LibreSolid/Metamaquina2/(list of files, cad)

Other CAD files:
Metamaquina_2_extruders.scad
