LibreSolid/Metamaquina2/metamaquina2/y_axis/motor/motor_holder.py

"""The lasercut plate that hangs the Y motor off the rear bars."""

from metamaquina2.part import SheetPart
from metamaquina2.scad import machine


class YMotorHolder(SheetPart):
    """One plate, slotted so the motor can be moved to tension the belt."""

    def profile(self):
        return machine.YMotorHolder_face()
