LibreSolid/Metamaquina2/metamaquina2/x_stage/carriage/belt_clamp.py

"""An X belt clamp and the bolts that tighten it."""

from solid_node.node import AssemblyNode
from solid_node.parameters import Flag, Length

from metamaquina2.hardware.bolt import Bolt
from metamaquina2.hardware.m3_washer import M3Washer
from metamaquina2.params import m3_washer_thickness
from metamaquina2.x_stage.carriage.belt_clamp_plate import XBeltClampPlate


class XBeltClamp(AssemblyNode):
    """One clamp: a plate and two M3x20 through it into the carriage.

    `flipped` is the other end of the belt.  The design mirrors the
    clamp there, and a flat plate mirrored in its own plane is the same
    piece turned over -- so it is turned over, and lifted back by its
    own thickness so it still lies where it was.  The bolts are on the
    mirror line, so they are the same either way.
    """

    # where the two bolts stand either side of the clamp's centre
    bolt_offset = 9

    bolt_length = Length(20.0, min=0)

    flipped = Flag(False)

    plate = XBeltClampPlate()
    washers = M3Washer().repeat(2)
    bolts = Bolt(diameter=3, length=bolt_length).repeat(2)

    def render(self):
        if self.flipped:
            (self.plate
             .rotate(180, [1, 0, 0])
             .translate([0, 0, XBeltClampPlate.clamp_thickness]))

        for index, side in enumerate((-1, 1)):
            (self.washers[index]
             .translate([side * self.bolt_offset, 0, 0])
             .rotate(180, [1, 0, 0]))
            (self.bolts[index]
             .translate([0, 0, m3_washer_thickness])
             .translate([side * self.bolt_offset, 0, 0])
             .rotate(180, [1, 0, 0]))
