LibreSolid/Metamaquina2/metamaquina2/y_axis/platform/sandwich_bolt.py

"""The washer and bolt that pull a bearing sandwich together."""

from solid_node.node import AssemblyNode
from solid_node.parameters import Length

from metamaquina2.hardware.bolt import Bolt
from metamaquina2.hardware.m3_washer import M3Washer
from metamaquina2.params import m3_washer_thickness


class SandwichBolt(AssemblyNode):
    """One M3x30 through the platform, its spacers and its sandwich
    plate, with a washer under the head.

    Drawn head-up from the origin; the platform turns it over to drive
    it downwards.
    """

    length = Length(30.0, min=0)

    washer = M3Washer()
    bolt = Bolt(diameter=3, length=length)

    def render(self):
        self.bolt.translate([0, 0, m3_washer_thickness])
