LibreSolid/Metamaquina2/metamaquina2/x_stage/ends/bearing_sandwich.py

"""The bearing sandwich of an X end: a plate and the spacers behind it."""

from solid_node.node import AssemblyNode

from metamaquina2.hardware.double_m3_spacer import DoubleM3Spacer
from metamaquina2.params import bearing_sandwich_spacing, thickness
from metamaquina2.x_stage.ends.sandwich_plate import XEndSandwichPlate


#: Where the four pairs of stacked spacers stand in the plate's plane.
SPACER_HOLES = ((-14, 0), (-14, 45), (14, 0), (14, 45))


class XEndBearingSandwich(AssemblyNode):
    """What holds the two Z bearings against the back plate.

    Four pairs of stacked spacers set the gap and one plate closes it,
    so the bearings are clamped rather than glued in.  It stands on
    edge: the plate faces along the beam.
    """

    spacer_holes = SPACER_HOLES

    spacers = DoubleM3Spacer().repeat(len(SPACER_HOLES))
    plate = XEndSandwichPlate()

    def render(self):
        def standing(node, offset):
            return (node
                    .rotate(90, [0, 0, 1])
                    .rotate(90, [0, 1, 0])
                    .translate([offset, 0, 0]))

        for spacer, (x, y) in zip(self.spacers, self.spacer_holes):
            standing(spacer.translate([x, y, 0]), thickness)
        standing(self.plate, thickness + bearing_sandwich_spacing)
