LibreSolid/Metamaquina2/metamaquina2/frame/panels/rod_ends/rod_end_top.py

"""The plate that caps a Z rod and Z bar at the top of the machine."""

from metamaquina2.part import SheetPart
from metamaquina2.scad import machine


class RodEndTop(SheetPart):
    """One of the two upper rod-end plates, above the top panel."""

    def profile(self):
        return machine.RodEndTop_face()
