LibreSolid/Metamaquina2/metamaquina2/x_stage/carriage/belt_clamp_plate.py

"""A lasercut clamp that grips the X belt at the carriage."""

from metamaquina2.part import SheetPart
from metamaquina2.scad import belt_clamp


class XBeltClampPlate(SheetPart):
    """One clamp plate.  The two ends of the belt are clamped by a
    left-hand and a right-hand one -- which is the same part, turned
    over."""

    width = 28
    radius = 5
    clamp_thickness = 6
    sheet_thickness = clamp_thickness

    def profile(self):
        return belt_clamp.beltclamp_curves(
            self.width, self.radius, for_x_carriage=True)
