LibreSolid/Metamaquina2/metamaquina2/x_stage/ends/idler/plain_plate.py

"""The blank side of the idler-side X end box."""

from metamaquina2.part import SheetPart
from metamaquina2.scad import machine


class XEndIdlerPlainPlate(SheetPart):
    """The side of the box away from the belt."""

    def profile(self):
        return machine.XEndIdler_plain_face()
