LibreSolid/Metamaquina2/metamaquina2/x_stage/platform_plate.py

"""The floor of the X beam."""

from metamaquina2.part import SheetPart
from metamaquina2.scad import machine


class XPlatformPlate(SheetPart):
    """The long sheet that spans between the two X ends, under the rods."""

    def profile(self):
        return machine.XPlatform_bottom_face()
