LibreSolid/Metamaquina2/metamaquina2/y_axis/platform/left_sandwich.py

"""The left bearing sandwich plate of the Y platform."""

from metamaquina2.part import SheetPart
from metamaquina2.scad import machine


class LeftBearingSandwich(SheetPart):
    """The plate that traps the single left-hand Y bearing.

    Asymmetric on purpose: the design shapes and places it so the
    heated bed's wiring can move freely past it instead of catching in
    a corner.
    """

    def profile(self):
        return machine.YPlatform_left_sandwich_face()
