LibreSolid/Metamaquina2/(commit log)

2026-08-26 Read the machine as a solid-node tree
    The OpenSCAD design stays exactly as it is; this adds a second reading
    of it: a solid_node.node tree in which every part a builder handles is
    a leaf and every subassembly that goes together before it goes into
    something bigger is an AssemblyNode. Dimensions are probed from the
    OpenSCAD sources at import (params.py), geometry comes from the .scad
    modules (scad.py, part.py), and the tests assert placement contracts --
    bearings on their rods, the bed covering the build volume -- which is
    the one thing this layer is responsible for.
    pyproject.toml declares the model entry point for the solid CLI and
    the studio profile.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
2026-08-26 Drive the three axes from the design's own car positions
    The .scad file already decided where a machine at rest is drawn, with
    XCarPosition, YCarPosition and ZCarPosition. Those three numbers are
    now drivers on the Metamaquina2 root, in the same coordinates, with the
    same numbers as defaults, so the model that opens is the model this
    repository has always rendered -- every one of the 412 leaves lands on
    identical world bounds at the defaults -- and it can now be sent
    somewhere else without editing anything. Declaring them on the root is
    what puts three sliders and the instruction buttons in front of whoever
    opens the machine, rather than buried one axis down.
    X and Y are relayed into the as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
2026-08-27 Read the three axis positions as the drivers they are
    The machine declares x, y and z as drivers and then read them back as
    `self.state['x']`, `self.state['y']`, `self.state['z']` -- three
    string keys for three names the class spells out ten lines above.
    solid-node now reads a declared driver as an attribute of its node,
    the way it has always read a port, so the keys are just `self.x`,
    `self.y` and `self.z`.
    Nothing about the machine changes: same drivers, same defaults, same
    relay into the X and Y ports, same lift on Z. All twelve contracts
    pass.
2026-08-29 Give both driven axes the toothed belts they really run
    The X carriage and the bed are pulled by GT2 belt, and the design draws
    that belt as a 2 mm ring hulled around the circles it wraps: no teeth,
    and no way to follow anything. The last commit left both belts standing
    still and said why -- a belt that follows its carriage is a shape to
    re-draw rather than re-place. solid-node now has a leaf kind for exactly
    that, so both belts are re-drawn.
    Each is a `MolejoNode`: a closed section swept along a wrap around the
    circles the loop runs, teeth displacing its inner face, and one port --
    `clamp`, where along the run the carriage holds the belt. The axis wires
    that port from the same carriage pos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
2026-08-30 Give both belt motors the pulley the design never drew
    The design buys a "GT2 pulley 6mm x 16 teeth" in its bill of materials
    and calls `GT2_pulley()` from both motors that drive a belt, and the
    module is empty: a BOM line and a `//TODO: implement-me!`. So the X
    belt was drawn meshed on nothing and the Y motor turned nothing. Both
    motors now carry the part, and the X one is meshed with its belt at
    every position the carriage can reach.
    The pulley could not be recovered from the .scad even in principle.
    What makes a pulley mesh is that its surface is the belt's inner
    surface, and the belt's inner surface is molejo's, so the part is drawn
    in `hardware/gt2_pulley.py` from the one description o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
2026-08-30 Buy the pulley the bill of materials buys
    The X end was dimensioned for a pulley nobody sells. `PulleyRadius`
    said 6, and 6 is no GT2 pulley at all: a belt meshed on it wraps a
    6.254 pitch circle, which carries 19.66 teeth, and a pulley has a
    whole number of them or it does not mesh. Which one it should have
    been is not a matter of rounding to the nearest, because the design
    says -- it buys "GT2 pulley 6mm x 16 teeth", ref GT2P6x16_Al, once at
    each belt motor. Sixteen 2 mm teeth make a 10.186 mm pitch circle,
    and a GT2 belt's pitch line runs 0.254 above the flanks it rides on,
    so that pulley carries its belt at 4.839. The round 6 stood a
    millimetre and a sixth outside it.
    So the design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
    [CalibrationZBars.scad, Metamaquina2.scad, Metamaquina_2_extruders.scad]
2026-08-30 Thread the Y belt over the pulley that drives it
    The Y axis had no drive. Its loop ran three bare 608 bearings and passed
    22.5 mm clear of the motor pulley -- the belt in one place, the pulley in
    another, nothing between them -- and the pulley was drawn not turning,
    with a comment explaining that there was nothing for its teeth to engage.
    That comment was true of the drawing and false of the machine.
    What the machine does is what its two rear bearings are for. They stand
    58 mm apart with the motor 40 mm inside the line between them, and the
    belt is threaded between them and over the pulley: it leaves the upper
    bearing on an internal tangent, hugs the pulley from the far side through
    156 d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
2026-08-30 Keep the Y pulley's angle out of a parser's way
    The pulley turned backwards in the browser and correctly in Python, and
    the difference was arithmetic rather than geometry.
    `solid_node.viewers.widget` evaluates a serialized expression with
    jokenizer 0.4.5, which parses subtraction right-associatively: it reads
    `1 - 2 - 3` as 2, `10 / 2 - 1 + 4` as 0, and a leading unary minus as
    swallowing the whole sum after it, so `-a + b` becomes `-(a + b)`. Of
    the eleven driver-dependent expressions this machine publishes, exactly
    one had that shape and it was this pulley's. The constant survived the
    negation and the term carrying `y` did not, so the browser turned it
    +11.245 degrees per millimetre of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
2026-08-30 Hang the X stage on the thread its nuts really climb
    Nothing held the Z axis up. The two bars were `cylinder(r=4)`, which
    is what the design draws and what this layer had faithfully repeated,
    and there was no nut on them at all: the beam floated at a height
    somebody typed in. That is a model with nothing in it to be wrong
    about -- a nut on a plain cylinder does not hang on anything, a
    cylinder that turns lifts nothing, and no assertion could tell the
    difference between a machine and a picture of one.
    The bars are M8 thread now, drawn rather than named. `thread.py` is
    the ISO basic profile -- a 60 degree V of height `P*sqrt(3)/2`,
    truncated `P/8` across the crest and `P/6` across the root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
    [x_end_idler.py, x_end_motor.py]
2026-08-30 Write down what the wrapper already keeps
    A month of commits built the solid-node reading of this machine and
    proved its contracts in tests, but the promises themselves lived only
    in docstrings and commit messages. This is those promises as an
    OpenSpec base: five capability specs describing what the layer
    observably does today -- reading the OpenSCAD design as the single
    source of truth, the assembly tree that follows the build, the three
    drivers and their instructions, the toothed belts and their pulleys,
    and the thread the beam hangs on.
    Nothing here is aspirational; every requirement is one the suite
    already holds green, and the two whole-model contracts deliberately
    not asserted are re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
2026-08-30 Propose the springs the design buys and never drew
    Six compression springs are bought in the bill of materials and drawn
    nowhere: four under the heated bed, so a nut at each corner can level
    it, and two on the extruder handle's bolts, so the idler presses
    filament onto the hobbed bolt. Both sit inside a block the design
    heads "TODO: Add these parts to the CAD model".
    A spring is what solid-node's flexible leaf is for -- its shape, not
    just its placement, follows the machine -- and it is what molejo is
    named after. The belts proved the technology here; a helix is the
    other half of the vocabulary.
    The bed spring also settles a place where the design states one height
    twice: pcb_height coun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
2026-08-30 Draw the six springs the bill of materials buys
    Four under the heated bed, on the corner holes the design cuts through
    the board and, from the same module, through the platform sheet under
    it: an M3x30 through each, three washers, the spring, and a nut below
    that a maker turns to level the bed. Two on the extruder handle's long
    bolts, seated on the far face of the idler's back plate, where
    compressing one swings the bearing onto the filament.
    The catalogue line the design buys a spring by gives a diameter and a
    free length and no wire and no turn count, so both are derived: the
    wire is what leaves half a millimetre of bore over the shank it runs
    on, and the turns are as many as still leave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
2026-08-30 Propose the hot end the machine measures itself from
    The design buys five parts for a J-head and models none of them: the
    one file that would draw the PEEK body still carries the conflict
    markers of an unfinished merge, so OpenSCAD drops the module and the
    whole machine has been rendering with nothing under the carriage.
    That is where Z is measured from. `nozzle_tip_distance` lifts the
    entire X platform so that the nozzle tip stands `ZCarPosition` above
    the build surface, and every Z contract in this repository is written
    against a point no drawn part reaches.
    The two dimensioned shop drawings are in `doc/`. This proposes the hot
    end off them, with two numbers derived rather than written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
2026-08-30 Hang the hot end the machine measures its Z from
    Five bought parts, assembled the way a builder assembles them: the PEEK
    holder standing its 5/8" shoulder on the extruder's underside with its
    collar and neck up inside the block, the PTFE liner pushed down the
    bore, the brass nozzle run into the holder's foot until its heater
    block meets the shoulder, and the resistor and thermistor pushed into
    the two holes the block is drilled with.
    The nozzle is the design's own `v4nozzle`, which is the brass drawing
    already transcribed. The other four are drawn from the two dimensioned
    shop drawings in `doc/`, because the design's own PEEK module is in a
    file that has never parsed and the liner's is a t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
2026-08-30 Propose the filament the design names three times and draws nowhere
    The reel beside the machine is a tube of ABS and there is nothing
    between it and the extruder, while the design states the stock's
    diameter three times over: `diameter=3` declared and unused in the file
    that draws the reel, the liner bored 3.0 for it, and a 3.2 channel cut
    up through the extruder for it to arrive by.
    The free run from a stand that does not move to a head that moves in X
    and in Z is the flexible leaf case after springs and belts, and the one
    a sampled representation could only serve with a grid over both axes.
2026-08-30 Thread the machine with the filament it eats
    The outermost layer of the reel is drawn as the strand it is -- fifty-two
    whole turns at the stock's own pitch, on a tube drawn to what is wound
    under them, still coming to the design's own 160 -- and the same strand
    runs on to the extruder as one sweep, a helix continued by a spline that
    leaves it the way it came.
    The free run is pinned at two points and both are the machine's to say.
    A run drawn straight from the stand to the extruder goes through the
    frame's right-hand panel, the beam's plate and the box at its end, so it
    crosses at the machine's own edge two stock diameters over the highest
    sheet the frame carries, and comes down through the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
2026-08-30 Propose carrying the run over the head and not only over the frame
    The routing contract asked each axis' ends with the other at rest, so
    the corners of the travel were never asked, and the run only fails at a
    corner: beam at the build surface, carriage on the spool's side, and it
    cuts the frame's right-hand side panel, its top panel and both rod-end
    plates over the right-hand Z rod.
    The crossing was derived from the highest sheet the frame carries, on
    the stated ground that nothing on this machine stands above it. The Z
    travel does not top out at the pose the design draws, and at the top of
    it the beam lifts the extruder's channel mouth and the handle plate
    above it well clear of the frame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
2026-08-30 Carry the run over the print head and not only over the frame
    The crossing stood two stock diameters over the highest sheet the frame
    carries, on the stated ground that nothing on this machine stands above
    it. ZCarPosition is the middle of the Z travel and not the top: wind
    the beam up to BuildVolume_Z and it carries the extruder's channel
    mouth out through the top panel's own opening with the handle plate
    thirty millimetres above that. The frame is not what the run has to
    get over.
    Pinned that low the run had to fall a hundred and sixty millimetres in
    the hundred and seventeen the crossing left it, so it left the crossing
    already dropping and reached the right-hand side panel below the t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
2026-09-02 refactor(hardware,frame): declare the fasteners and the frame
    The bought parts that come in sizes -- the bolt, the smooth rod, the
    threaded bar and the GT2 pulley -- state their sizes as declared
    parameters instead of forwarding them by hand, so a size cannot reach
    the geometry without reaching the artifact key. The extruder's idler
    axle is now the rod's own two parameters redeclared and needs no
    constructor at all.
    The frame's assemblies declare their parts in the class body and
    position them in render(): the panels, the rod ends, the t-slot
    joints, the bar caps, the clamp mounts and the two bar assemblies.
    Where the same part appears more than once with only a placement
    between them -- f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
2026-09-02 refactor(z-axis,y-axis,electronics): declare the axes and the wiring
    The Z axis, the Y axis, the spool holder and the electronics declare
    their parts in the class body and position them in render(). Every
    part that appears more than once with only a placement between them is
    one declaration repeated: two Z bars, two couplings, two rods, two
    motors, four levelling screws, four belt clamps, five pairs of
    spacers, three bearings, seven sandwich bolts, four RAMBo corner
    stacks, both uprights of the stand and every t-slot bolt on them.
    A spring now derives what the catalogue does not give it.
    `wire_diameter`, `coil_radius` and `rise` were three properties over
    four hand-set class attributes; th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
2026-09-02 refactor(x-stage,machine): declare the beam, the extruder and the root
    The X stage, both its end boxes, the carriage, the extruder, the idler
    arm, the handle and the hot end declare their parts and position them
    in render(). The extruder's five slices declare their number as a
    Count with the block's own range as its constraint, so the check the
    class hand-wrote is a declaration; the two belt clamps are a literal
    list because the far one is the same plate turned over and its Flag
    says so in the artifact key.
    The machine itself is now a class body: seven assemblies declared, the
    drivers and instructions where they were, and a render() that places
    the stand and the strand, relays the three ax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
2026-09-02 refactor(parts): declare what a part is, not only where it sits
    A class constant that says what is built is a parameter, and the
    wrapper is what says so. The two extruder gears' tooth counts, the
    RAMBo cover bolt's head, the Y belt clamp's profile, the X idler's
    shaft and the four bolt lengths a subassembly buys are all what the
    part IS -- they reach the geometry -- so each is declared and each
    now reaches the artifact key. What says where a part sits stays a
    bare constant: bolt circles, setbacks, clamp offsets, clearances.
    `spring.wire()` goes with them. It was a module function called from
    a property to do arithmetic the algebra now does as a formula, and
    nothing else called it.
    READM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
    [belt_clamp.py, idler_pulley.py, level_screw.py, sandwich_bolt.py]
2026-09-02 refactor(clips,block,machine): say it in the class body
    Three workarounds go. The two module-level helpers that stood in for
    a comprehension -- `_clips()` for a panel's table of cable clips and
    `_slices()` for the five slices of the extruder block -- are the
    comprehensions they were written to be, in the class body, over the
    module-level table each iterates. The framework no longer loses a
    class body to Python's inlined comprehension frame, so what the design
    lists is read straight off its own table. The child names are the
    ones they always were: `left-0`..`left-7`, `slices-0`..`slices-4`.
    And the power supply's flag moves to where a maker meets it. It is
    the one part of this machine th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
2026-09-02 refactor(machine): place what stands still once
    A printer is mostly a thing that does not move. The frame, the
    panels, every t-slot bolt, every bearing and washer and nut, the
    electronics, the reel stand and the boxes at both ends of the beam are
    bolted where a builder bolts them and stay there; only the carriage,
    the bed, the two screws and the couplings on them, and the two pulleys
    the belts are meshed on follow a driver. So the placements split the
    way the framework now recommends: what never moves is applied once in
    `__init__` after `super().__init__(**kwargs)`, and `render()` keeps
    only what a driver reaches.
    Thirty-two assemblies place everything they hold once and no longer
    have a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
    [bearing_sandwich.py, belt_clamp.py, belt_side.py]
2026-09-03 refactor(machine): rest placement goes back into render()
    The framework withdrew the recommendation the last round followed.
    `render()` now builds the machine at rest -- structure, omissions and
    the placement of everything that does not move -- and it is run once
    per instance, so a placement stated there is the instance's and is
    never swept. `__init__` still works and is no longer the place for
    it.
    So the thirty-two assemblies that hold nothing a driver reaches say
    where their parts go in `render()` again, exactly as they did two
    rounds ago: the frame and its joints, every t-slot bolt, the panels
    and rod ends, the bars and their clamps, the RAMBo and the endstops
    and the clips, the power s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
    [bearing_sandwich.py, belt_clamp.py]
2026-09-03 refactor(machine): render() stands the machine, simulate() moves it
    Everything a driver reaches now says so in `simulate()`, the method
    the framework runs after `render()` on every instant. Thirteen
    assemblies split:
    * the machine relays X, Y and Z into the axes, lifts the stage to what
    the screws are worth, and pins the free run at the head -- all of it
    read off the three drivers, all of it per instant. What is left at
    rest is the reel stand beside the machine and the strand hanging on
    it;
    * both belt loops stand where their idlers and pulley hold them, and
    the carriage, the bed and the two pulley phases are told each
    instant;
    * both motor boxes stand plate, motor and pulley,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
2026-09-03 docs(readme): say which half of the machine moves
    The node tree section described what the tree adds without saying how
    it says it. It now names the split the framework's lifecycle gives
    it: `render()` is the machine at rest and runs once, `simulate()` is
    what the three drivers reach and runs on every instant, and motion
    composes inside rest placement.
    Claude-Session: https://claude.ai/code/session_01MRDKCB9UQDETpbMM2oKvGz
2026-09-04 refactor(imports): read parameter kinds from solid_node.parameters
    solid_node.node no longer exports Length, Flag or Count: the framework
    moved every build-parameter kind into a dedicated solid_node.parameters
    module so an import line says what each name is for, rather than
    mixing node classes and ports with the declarations that size and gate
    them. Split every import that mixed the two, keeping node classes and
    ports on solid_node.node and moving Length, Flag and Count to
    solid_node.parameters, alphabetically ordered within each line.
    Nothing else changes: geometry, lifecycle methods, parameter values
    and ports are untouched. The full suite still passes 67 of 67, the
    root node still builds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
    [bed_spring.py, belt_clamp.py]
2026-09-09 refactor(simulation): import ports from solid_node.motion
    solid-node main moved Port, RotationalPort, TranslationalPort,
    SignalPort, Time, bind, connect and declared_ports out of
    solid_node.node into solid_node.motion.ports with no re-export. Fix
    only the import lines in the twelve modules that name a moved port
    kind: filament.py, spring.py (MolejoNode stays from solid_node.node),
    x_stage/x_belt.py, y_axis/y_belt.py, x_stage/x_stage.py,
    y_axis/y_axis.py (AssemblyNode stays), z_axis/z_axis.py,
    z_axis/z_bars.py, z_axis/z_couplings.py,
    x_stage/ends/motor/x_end_motor.py,
    x_stage/ends/motor/belt_side.py, y_axis/motor/y_motor.py
    (AssemblyNode stays). test_metamaquina2.py imports no moved name and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
    [belt_side.py, x_belt.py, x_end_motor.py, x_stage.py]
2026-09-09 refactor(simulation): move the Metamaquina 2 onto solid-node joints and couplings
    Five joint declarations on the bodies that move: XStage.lift,
    XCarriage.travel, YPlatform.slide (Prismatic), and XPulley.spin,
    YPulley.spin (Revolute, on new three-line GT2Pulley subclasses in
    belt_side.py and y_motor.py). Two wirings carry each motor's shaft
    into its pulley (pulley = XPulley(period=PERIOD, spin=shaft), same
    for Y), replacing XEndMotorBeltSide.simulate() and YMotor.simulate().
    Nine drives() relations replace the hand-written chain: five on
    Metamaquina2 (x -> x_stage.carriage.travel, y -> y_axis.platform.slide,
    z -> x_stage.lift at the screw scale, z -> z_axis.bars.angle and
    z_axis.couplings.an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
    [belt_side.py, x_belt.py, x_carriage.py, x_end_motor.py, x_stage.py]
2026-09-09 openspec(move-onto-motion): archive the reviewed motion refactor
    Five joint declarations, two wirings, nine relations across twelve of
    seventy modules; poses bit-identical over 18 poses; 67/67 before and
    after. Nothing to sync.
    Claude-Session: https://claude.ai/code/session_01S1kmkQ71KNopZD5MTF2Khq
2026-09-10 refactor(motion): state joints in the declaring body's own frame (ADR-097); declare Z bars and couplings as fan-out joints (ADR-096)
    Stage B of the joint-frame-follows-declarer campaign for this project.
    - YPulley.spin and XPulley.spin restated in their own rest frame: the
    YPulley axis carries (-1,0,0) parent-frame -> (0,0,1) local, both
    anchors dropped as inert (their only nonzero component lay along the
    new axis, restating the parent's own translate).
    - ZBars and ZCouplings: added SpinningThreadedRod (ThreadedRod
    subclass, so the frame's four static bars stay unaffected) and
    ShaftCoupling.spin, both Revolute(axis=(0,0,1), unit='deg') with no
    anchor. Each class now declares one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
2026-09-10 openspec(declare-what-turns-in-its-own-frame): archive the ADR-096/097 migration
    Claude-Session: https://claude.ai/code/session_01TYDL4GUJ72pvaCpyE5pXxQ
